critterandguitari/MelodyMillPCB/README.md

# MelodyMillPCB
PCB for Melody Mill Eurorack Module

License is CC BY-SA 2.0
