critterandguitari/MelodyMillPCB/ConectorBoard/pp_module_jack_rev_b_6_up/pp_module_jack_rev_b_6_up_FAB_DRAWING.png

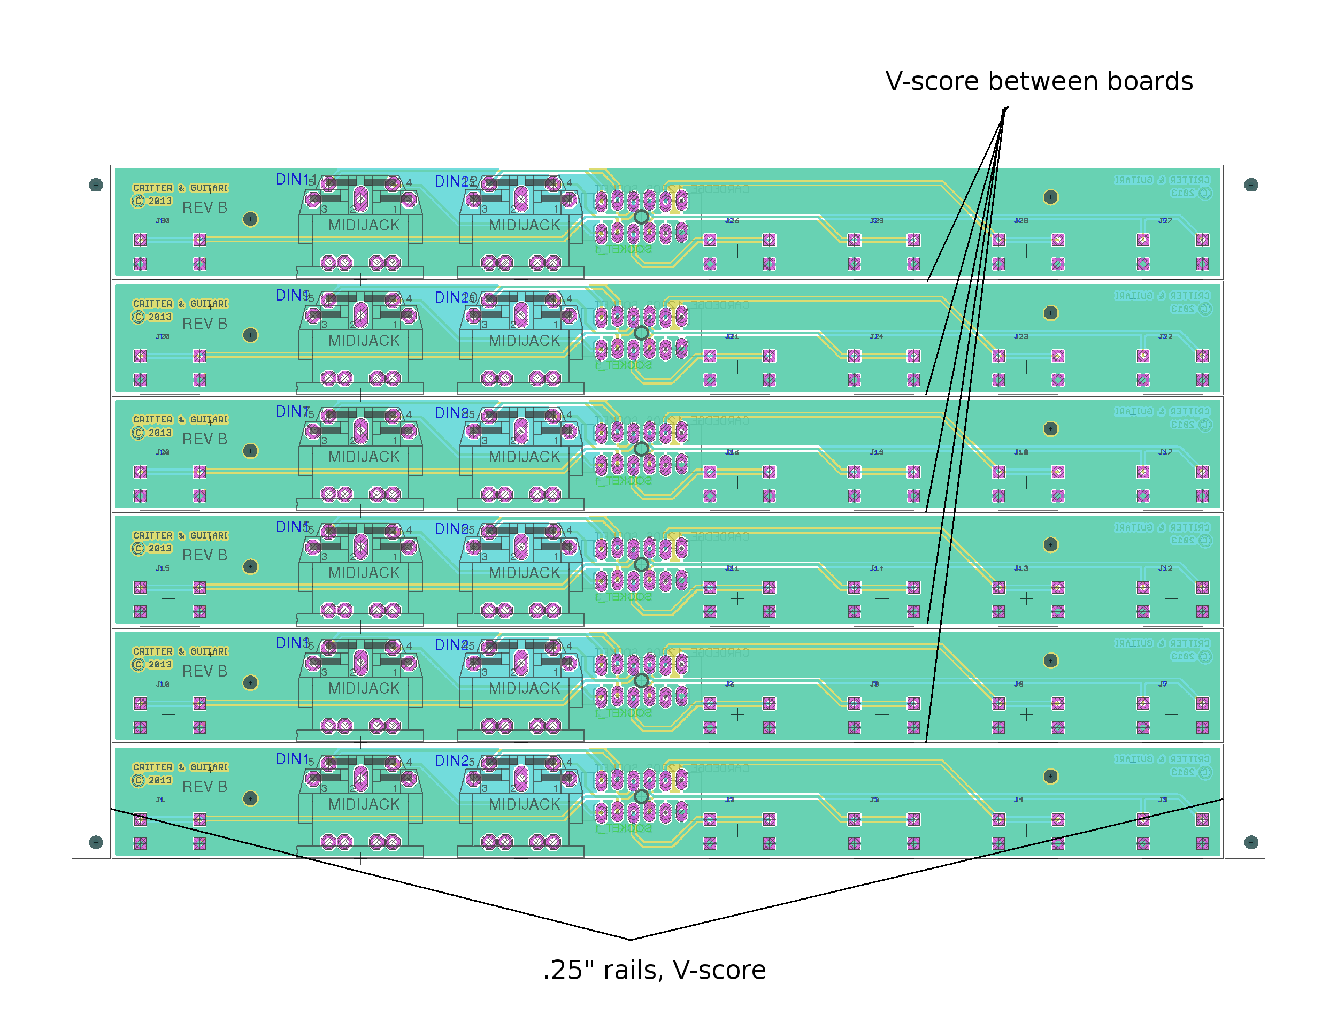
ConectorBoard/pp_module_jack_rev_b_6_up/pp_module_jack_rev_b_6_up_FAB_DRAWING.png
