critterandguitari/MelodyMillPCB/pp_module_rev_c_3_up/pp_module_rev_c_3_up_FAB_DRAWING.png

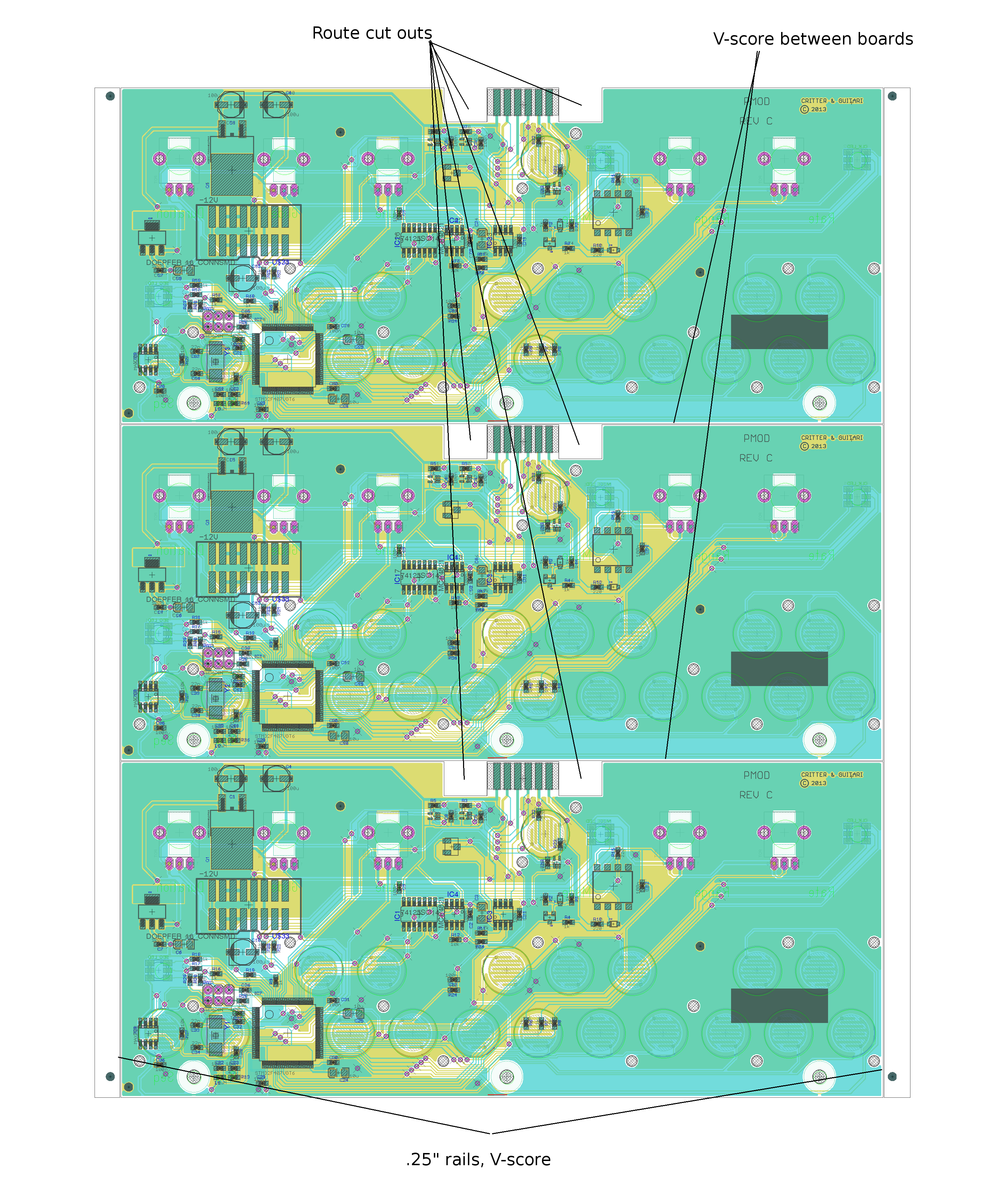
pp_module_rev_c_3_up/pp_module_rev_c_3_up_FAB_DRAWING.png
