critterandguitari/MelodyMillPCB/ConectorBoard/pp_module_jack_rev_b.brd

## EAGLE design ConectorBoard/pp_module_jack_rev_b.brd (2016-05-31)

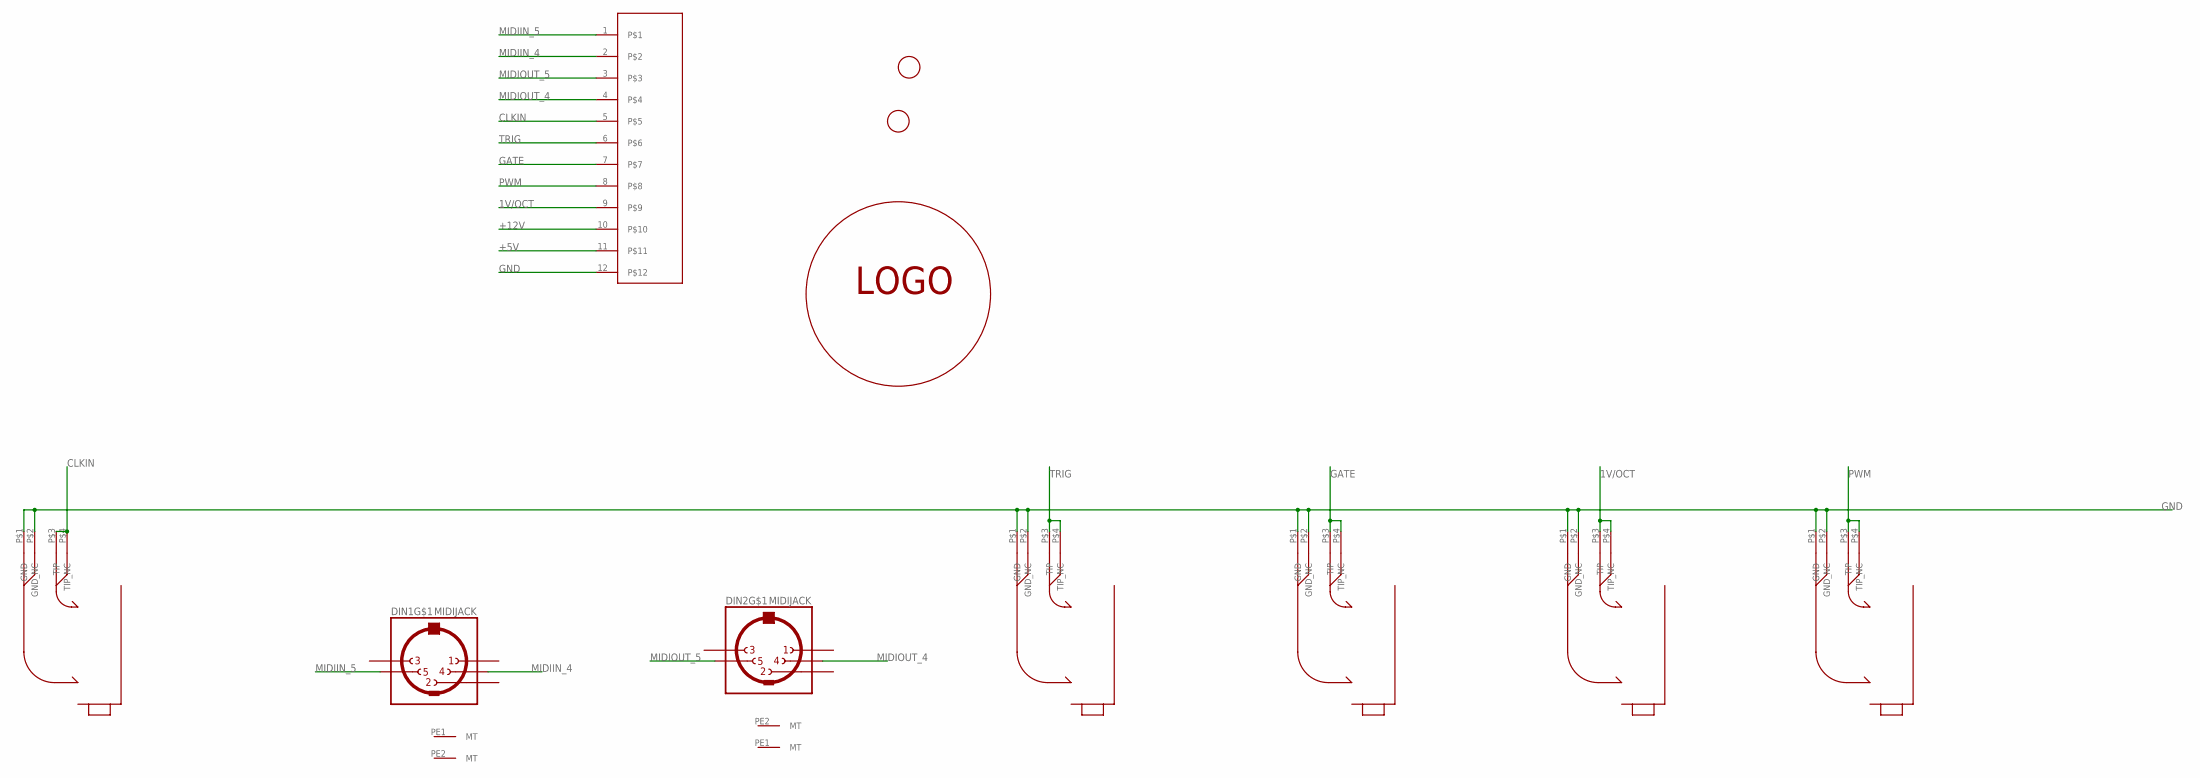
[picture p3: schematic pp_module_jack_rev_b.sch]

Parts:
DIN1, DIN2: MIDIJACK; CP-2350
J1, J2, J3, J4, J5: MONO_JACKCLIFF; CLIFF_JACK
SOCKET_1: CARDEDGE_12POS_SOCKET
U$1, U$2: FIDUCIAL; FIDUCIAL_1MM
U$10: LOGOCG; LOGO-CG

Connections:
1V/OCT: J4.P$3 (TIP), J4.P$4 (TIP_NC), SOCKET_1.9
+5V: SOCKET_1.11
+12V: SOCKET_1.10
CLKIN: J1.P$3 (TIP), J1.P$4 (TIP_NC), SOCKET_1.5
GATE: J3.P$3 (TIP), J3.P$4 (TIP_NC), SOCKET_1.7
GND: J1.P$1 (GND), J1.P$2 (GND_NC), J2.P$1 (GND), J2.P$2 (GND_NC), J3.P$1 (GND), J3.P$2 (GND_NC), J4.P$1 (GND), J4.P$2 (GND_NC), J5.P$1 (GND), J5.P$2 (GND_NC), SOCKET_1.12
MIDIIN_4: DIN1.4, SOCKET_1.2
MIDIIN_5: DIN1.5, SOCKET_1.1
MIDIOUT_4: DIN2.4, SOCKET_1.4
MIDIOUT_5: DIN2.5, SOCKET_1.3
PWM: J5.P$3 (TIP), J5.P$4 (TIP_NC), SOCKET_1.8
TRIG: J2.P$3 (TIP), J2.P$4 (TIP_NC), SOCKET_1.6

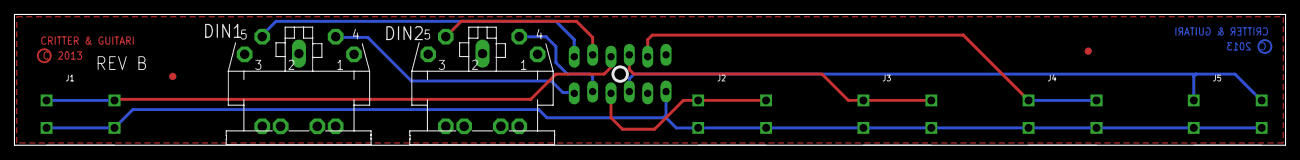
[picture p4: board pp_module_jack_rev_b.brd from above]

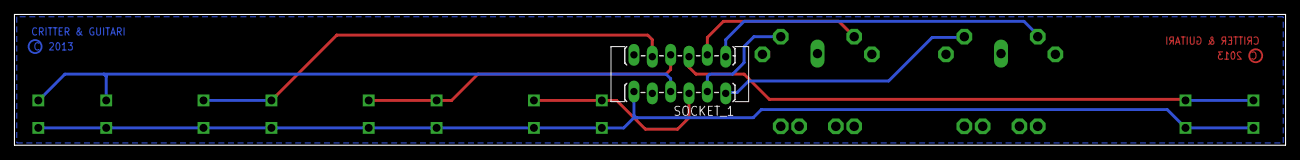
[picture p5: board pp_module_jack_rev_b.brd from below]

Board: 2 copper layers, 175.9 x 18.1 mm, 12 parts (2 on the bottom side), 10 nets.

Other parts of the board:
U$9: LOGOCG; LOGO-CG
