critterandguitari/MelodyMillPCB/pp_module_rev_c.brd

## EAGLE design pp_module_rev_c.brd (2016-05-24)

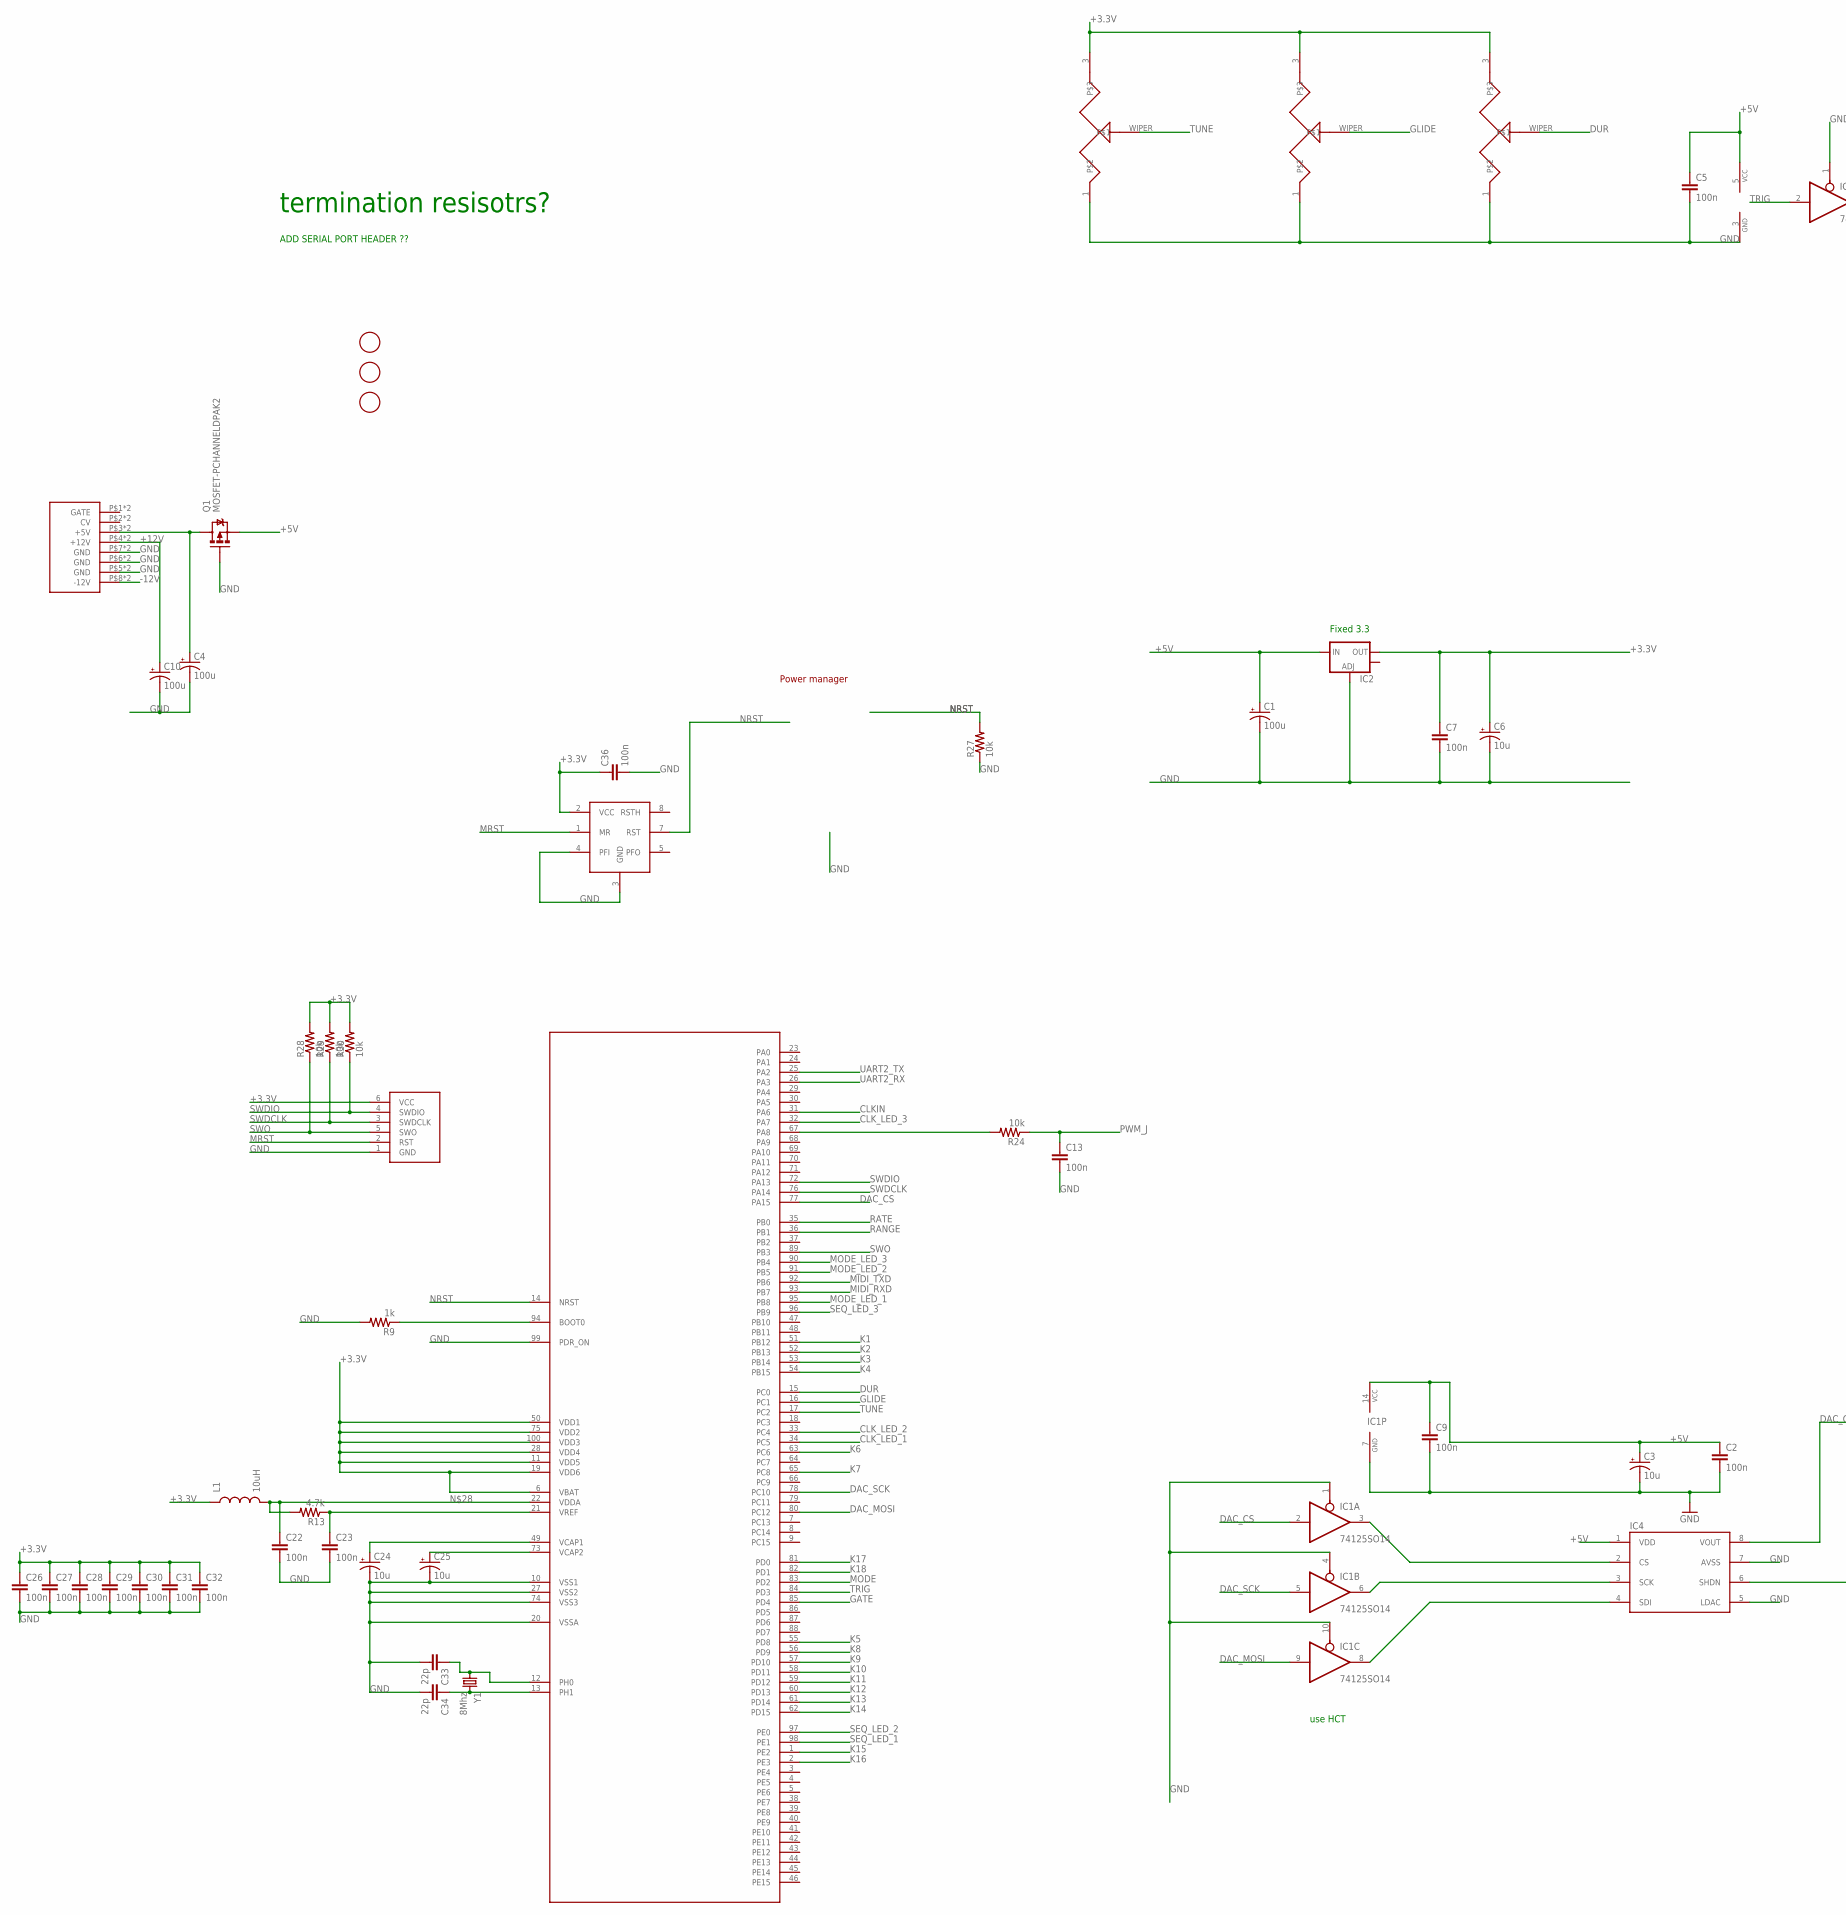
[picture p6: schematic pp_module_rev_c.sch, part in row 1, column 1]

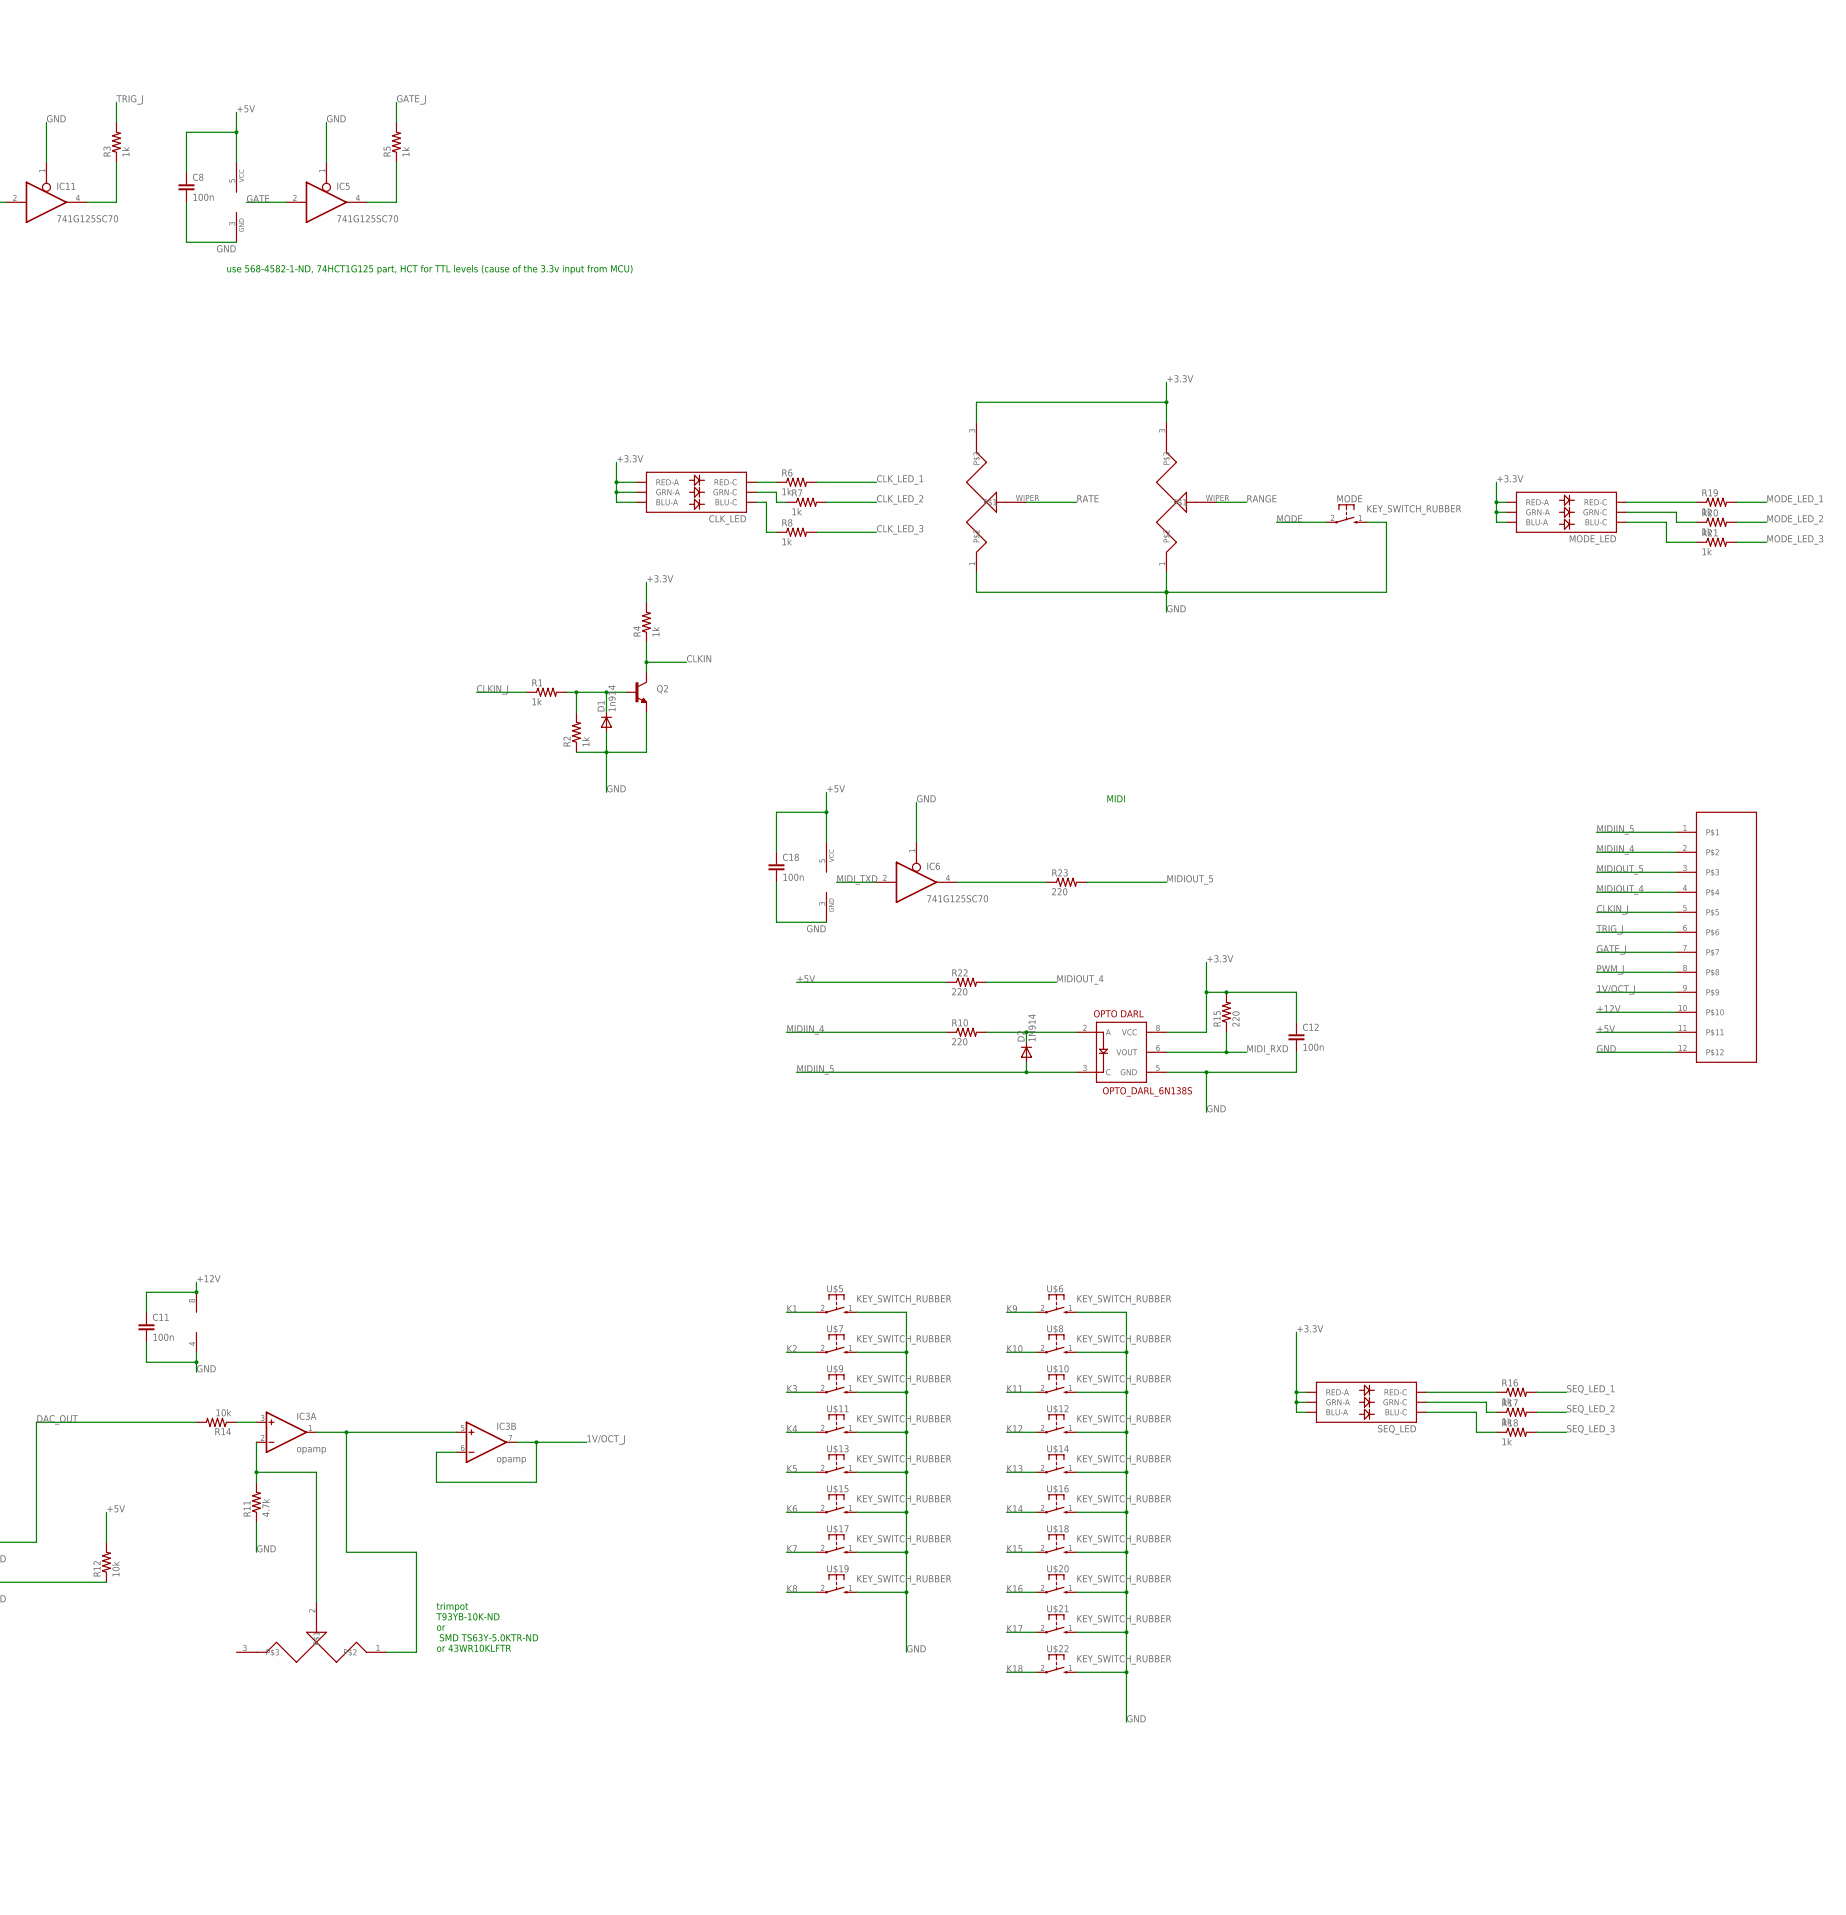
[picture p7: schematic pp_module_rev_c.sch, part in row 1, column 2]

Parts:
C1, C4, C10: 100u; PANASONIC_D
C2, C5, C7, C8, C9, C11, C12, C13, C18, C22, C23, C26, C27, C28, C29, C30, C31, C32, C36: 100n; 0603-CAP
C3, C6, C24, C25: 10u; EIA3216
C33, C34: 22p; 0603-CAP
CLK_LED: LED-TRICOLOR-5050
D1: 1n914; SOD-323
D2: 1N914; SOD-323
DUR: POTVERT; POT-P09X-VERT
GLIDE: POTVERT; POT-P09X-VERT
IC1: 74125SO14; SO14
IC2: V_REG_LM1117SOT223; SOT223
IC3: opamp; SO08
IC4: MCP4821; SO08
IC5, IC6, IC11: 741G125SC70; SC-70
IC7: STM32F407VGT6; LQFP100-14X14
IC9: MAX708; SO08
L1: 10uH; 0603
MODE: KEY_SWITCH_RUBBER; KEY_CONTACT_RUBBER
MODE_LED: LED-TRICOLOR-5050
Q1: MOSFET-PCHANNELDPAK2; DPAK2
Q2: TRANSISTOR_NPNSOT23-3; SOT23-3
R1, R2, R3, R4, R5, R6, R7, R8, R9, R16, R17, R18, R19, R20, R21: 1k; 0603-RES
R10, R15, R22, R23: 220; 0603-RES
R11, R13: 4.7k; 0603-RES
R12, R14, R24, R27, R28, R29, R30: 10k; 0603-RES
RANGE: POTVERT; POT-P09X-VERT
RATE: POTVERT; POT-P09X-VERT
SEQ_LED: LED-TRICOLOR-5050
SWD: SWD6PIN; 2X3
TUNE: POTVERT; POT-P09X-VERT
U$1, U$23, U$24: FIDUCIAL; FIDUCIAL_1MM
U$2: POTSMD-TRIMMER; POT-TRIM-TT-43
U$3: CARDEDGE_12POS_MALE
U$4: OPTO_DARL_6N138S; 8-SMD
U$5, U$6, U$7, U$8, U$9, U$10, U$11, U$12, U$13, U$14, U$15, U$16, U$17, U$18, U$19, U$20, U$21, U$22: KEY_SWITCH_RUBBER; KEY_CONTACT_RUBBER
U$33: DOEPFER_16_CONNSMD; 2X8SMD
Y1: 8Mhz; CRYSTAL-SMD

Connections:
1N914: D1.1 (C), Q2.1 (B), R1.2, R2.2
1V/OCT_J: IC3.6 (-IN), IC3.7 (OUT), U$3.9
+3.3V: C6.A (+), C7.1, C12.1, C26.1, C27.1, C28.1, C29.1, C30.1, C31.1, C32.1, C36.1, CLK_LED.1 (BLU-A), CLK_LED.3 (GRN-A), CLK_LED.5 (RED-A), DUR.3, GLIDE.3, IC2.2 (OUT), IC7.6 (VBAT), IC7.11 (VDD5), IC7.19 (VDD6), IC7.28 (VDD4), IC7.50 (VDD1), IC7.75 (VDD2), IC7.100 (VDD3), IC9.2 (VCC), L1.1, MODE_LED.1 (BLU-A), MODE_LED.3 (GRN-A), MODE_LED.5 (RED-A), R4.2, R15.2, R28.2, R29.2, R30.2, RANGE.3, RATE.3, SEQ_LED.1 (BLU-A), SEQ_LED.3 (GRN-A), SEQ_LED.5 (RED-A), SWD.6 (VCC), TUNE.3, U$4.8 (VCC)
+5V: C1.+, C2.1, C3.A (+), C5.1, C8.1, C9.1, C18.1, IC1.14 (VCC), IC2.3 (IN), IC4.1 (VDD), IC5.5 (VCC), IC6.5 (VCC), IC11.5 (VCC), Q1.3 (S), R12.2, R22.1, U$3.11
+12V: C10.+, C11.1, IC3.8 (V+), U$3.10, U$33.P$4 (+12V), U$33.P$12 (+12V)
-12V: U$33.P$8 (-12V), U$33.P$16 (-12V)
CLKIN: IC7.31 (PA6), Q2.3 (C), R4.1
CLKIN_J: R1.1, U$3.5
CLK_LED_1: IC7.34 (PC5), R6.2
CLK_LED_2: IC7.33 (PC4), R7.2
CLK_LED_3: IC7.32 (PA7), R8.2
DAC_CS: IC1.2 (I), IC7.77 (PA15)
DAC_MOSI: IC1.9 (I), IC7.80 (PC12)
DAC_OUT: IC4.8 (VOUT), R14.2
DAC_SCK: IC1.5 (I), IC7.78 (PC10)
DUR: DUR.WIPER, IC7.15 (PC0)
GATE: IC5.2 (I), IC7.85 (PD4)
GATE_J: R5.2, U$3.7
GLIDE: GLIDE.WIPER, IC7.16 (PC1)
GND: C1.-, C2.2, C3.C (-), C4.-, C5.2, C6.C (-), C7.2, C8.2, C9.2, C10.-, C11.2, C12.2, C13.2, C18.2, C22.2, C23.2, C24.C (-), C25.C (-), C26.2, C27.2, C28.2, C29.2, C30.2, C31.2, C32.2, C33.2, C34.2, C36.2, D1.2 (A), DUR.1, GLIDE.1, IC1.1 (OE), IC1.4 (OE), IC1.7 (GND), IC1.10 (OE), IC2.1 (ADJ), IC3.4 (V-), IC4.5 (LDAC), IC4.7 (AVSS), IC5.1 (OE), IC5.3 (GND), IC6.1 (OE), IC6.3 (GND), IC7.10 (VSS1), IC7.20 (VSSA), IC7.27 (VSS2), IC7.74 (VSS3), IC7.99 (PDR_ON), IC9.3 (GND), IC9.4 (PFI), IC11.1 (OE), IC11.3 (GND), MODE.1 (3), Q1.1 (G), Q2.2 (E), R2.1, R9.2, R11.1, R27.1, RANGE.1, RATE.1, SWD.1 (GND), TUNE.1, U$3.12, U$4.5 (GND), U$5.1 (3), U$6.1 (3), U$7.1 (3), U$8.1 (3), U$9.1 (3), U$10.1 (3), U$11.1 (3), U$12.1 (3), U$13.1 (3), U$14.1 (3), U$15.1 (3), U$16.1 (3), U$17.1 (3), U$18.1 (3), U$19.1 (3), U$20.1 (3), U$21.1 (3), U$22.1 (3), U$33.P$5 (GND), U$33.P$6 (GND), U$33.P$7 (GND), U$33.P$13 (GND), U$33.P$14 (GND), U$33.P$15 (GND)
K1: IC7.51 (PB12), U$5.2 (1)
K2: IC7.52 (PB13), U$7.2 (1)
K3: IC7.53 (PB14), U$9.2 (1)
K4: IC7.54 (PB15), U$11.2 (1)
K5: IC7.55 (PD8), U$13.2 (1)
K6: IC7.63 (PC6), U$15.2 (1)
K7: IC7.65 (PC8), U$17.2 (1)
K8: IC7.56 (PD9), U$19.2 (1)
K9: IC7.57 (PD10), U$6.2 (1)
K10: IC7.58 (PD11), U$8.2 (1)
K11: IC7.59 (PD12), U$10.2 (1)
K12: IC7.60 (PD13), U$12.2 (1)
K13: IC7.61 (PD14), U$14.2 (1)
K14: IC7.62 (PD15), U$16.2 (1)
K15: IC7.1 (PE2), U$18.2 (1)
K16: IC7.2 (PE3), U$20.2 (1)
K17: IC7.81 (PD0), U$21.2 (1)
K18: IC7.82 (PD1), U$22.2 (1)
MIDIIN_4: R10.1, U$3.2
MIDIIN_5: D2.2 (A), U$3.1, U$4.3 (C)
MIDIOUT_4: R22.2, U$3.4
MIDIOUT_5: R23.2, U$3.3
MIDI_RXD: IC7.93 (PB7), R15.1, U$4.6 (VOUT)
MIDI_TXD: IC6.2 (I), IC7.92 (PB6)
MODE: IC7.83 (PD2), MODE.2 (1)
MODE_LED_1: IC7.95 (PB8), R19.2
MODE_LED_2: IC7.91 (PB5), R20.2
MODE_LED_3: IC7.90 (PB4), R21.2
MRST: IC9.1 (MR), SWD.2 (RST)
unnamed: MODE_LED.6 (RED-C), R19.1
unnamed: MODE_LED.4 (GRN-C), R20.1
unnamed: C34.1, IC7.13 (PH1), Y1.2
unnamed: MODE_LED.2 (BLU-C), R21.1
unnamed: C24.A (+), IC7.49 (VCAP1)
unnamed: C33.1, IC7.12 (PH0), Y1.1
unnamed: IC3.2 (-IN), R11.2, U$2.2
unnamed: IC3.3 (+IN), R14.1
unnamed: C4.+, Q1.4 (D), U$33.P$3 (+5V), U$33.P$11 (+5V)
unnamed: IC11.4 (O), R3.1
unnamed: CLK_LED.6 (RED-C), R6.1
unnamed: IC5.4 (O), R5.1
unnamed: IC7.67 (PA8), R24.2
unnamed: CLK_LED.4 (GRN-C), R7.1
unnamed: CLK_LED.2 (BLU-C), R8.1
unnamed: C25.A (+), IC7.73 (VCAP2)
unnamed: IC4.6 (SHDN), R12.1
unnamed: R18.1, SEQ_LED.2 (BLU-C)
unnamed: R17.1, SEQ_LED.4 (GRN-C)
unnamed: IC7.94 (BOOT0), R9.1
unnamed: R16.1, SEQ_LED.6 (RED-C)
unnamed: IC3.1 (OUT), IC3.5 (+IN), U$2.1
unnamed: IC1.3 (O), IC4.2 (CS)
unnamed: C22.1, IC7.22 (VDDA), L1.2, R13.2
unnamed: C23.1, IC7.21 (VREF), R13.1
unnamed: D2.1 (C), R10.2, U$4.2 (A)
unnamed: IC6.4 (O), R23.1
unnamed: IC1.6 (O), IC4.3 (SCK)
unnamed: IC1.8 (O), IC4.4 (SDI)
NRST: IC7.14 (NRST), IC9.7 (RST), R27.2
PWM_J: C13.1, R24.1, U$3.8
RANGE: IC7.36 (PB1), RANGE.WIPER
RATE: IC7.35 (PB0), RATE.WIPER
SEQ_LED_1: IC7.98 (PE1), R16.2
SEQ_LED_2: IC7.97 (PE0), R17.2
SEQ_LED_3: IC7.96 (PB9), R18.2
SWDCLK: IC7.76 (PA14), R29.1, SWD.3 (SWDCLK)
SWDIO: IC7.72 (PA13), R30.1, SWD.4 (SWDIO)
SWO: IC7.89 (PB3), R28.1, SWD.5 (SWO)
TRIG: IC7.84 (PD3), IC11.2 (I)
TRIG_J: R3.2, U$3.6
TUNE: IC7.17 (PC2), TUNE.WIPER
UART2_RX: IC7.26 (PA3)
UART2_TX: IC7.25 (PA2)

Notes on the sheet:
termination resisotrs?
Power manager
ADD SERIAL PORT HEADER ??
Fixed 3.3
use 568-4582-1-ND, 74HCT1G125 part, HCT for TTL levels (cause of the 3.3v input from MCU)
trimpot T93YB-10K-ND or SMD TS63Y-5.0KTR-ND or 43WR10KLFTR
use HCT
MIDI

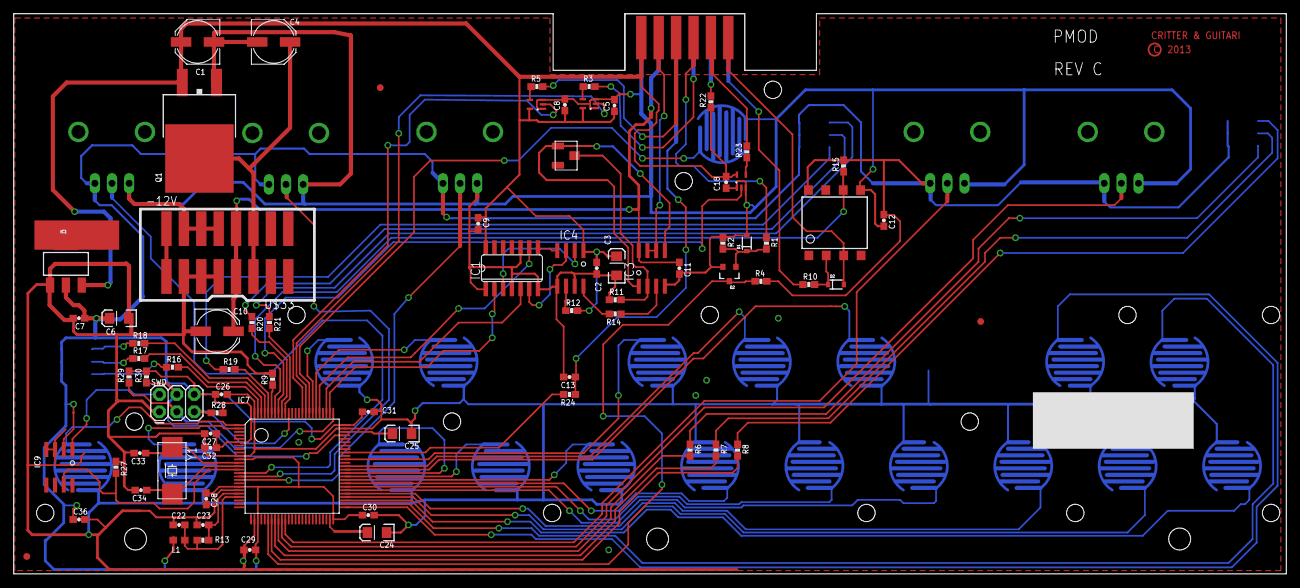
[picture p8: board pp_module_rev_c.brd from above]

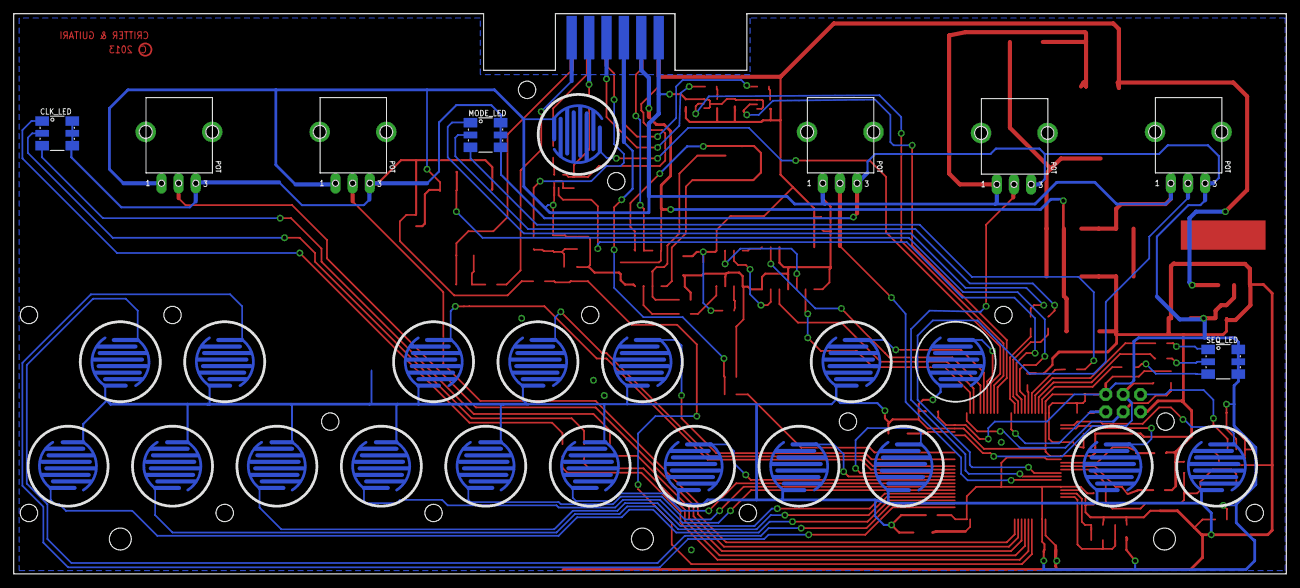
[picture p9: board pp_module_rev_c.brd from below]

Board: 2 copper layers, 185.7 x 81.8 mm, 107 parts (27 on the bottom side), 91 nets.

Other parts of the board:
U$25: LOGOCG; LOGO-CG
