critterandguitari/MelodyMillPCB/ConectorBoard/pp_module_jack_rev_b_6_up.brd

## EAGLE design ConectorBoard/pp_module_jack_rev_b_6_up.brd (2016-05-31)

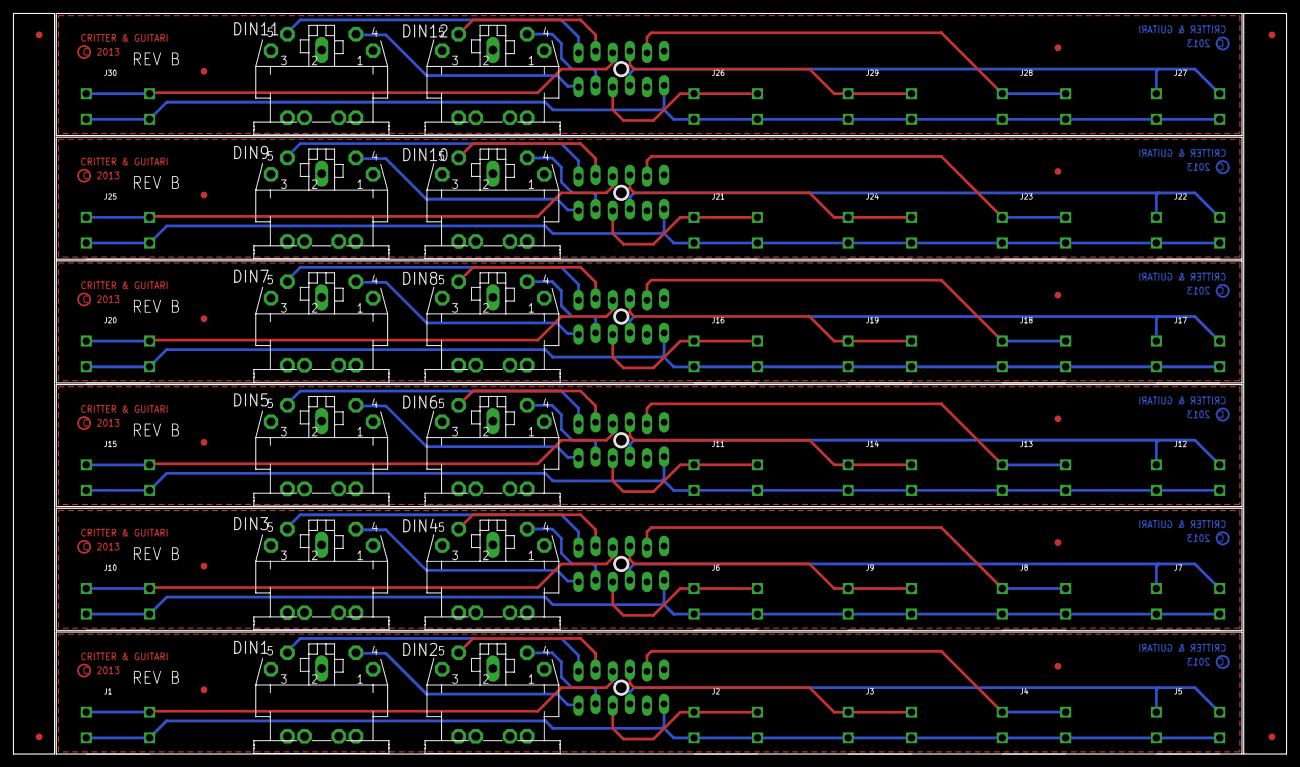
[picture p10: board pp_module_jack_rev_b_6_up.brd from above]

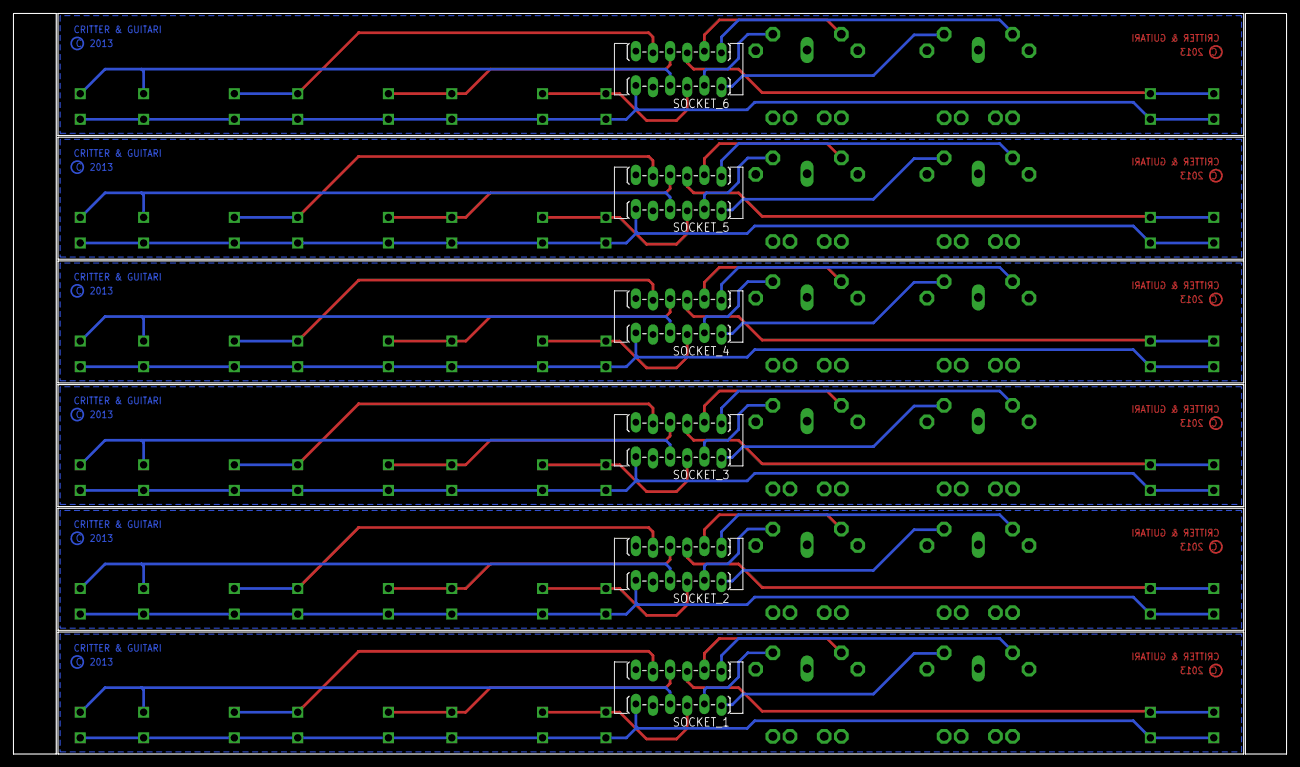
[picture p11: board pp_module_jack_rev_b_6_up.brd from below]

Board: 2 copper layers, 188.8 x 109.9 mm, 76 parts (12 on the bottom side), 60 nets.

Parts:
DIN1, DIN2, DIN3, DIN4, DIN5, DIN6, DIN7, DIN8, DIN9, DIN10, DIN11, DIN12: MIDIJACK; CP-2350
E$1, E$2, E$3, E$4: FIDUCIAL_1MM
J1, J2, J3, J4, J5, J6, J7, J8, J9, J10, J11, J12, J13, J14, J15, J16, J17, J18, J19, J20, J21, J22, J23, J24, J25, J26, J27, J28, J29, J30: MONO_JACKCLIFF; CLIFF_JACK
SOCKET_1, SOCKET_2, SOCKET_3, SOCKET_4, SOCKET_5, SOCKET_6: CARDEDGE_12POS_SOCKET
U$1, U$2, U$5, U$6, U$11, U$12, U$15, U$16, U$19, U$20, U$23, U$24: FIDUCIAL; FIDUCIAL_1MM
U$3, U$4, U$7, U$8, U$9, U$10, U$13, U$14, U$17, U$18, U$21, U$22: LOGOCG; LOGO-CG

Connections:
1V/OCT: J4.P$3, J4.P$4, SOCKET_1.9
1V/OCT1: J8.P$3, J8.P$4, SOCKET_2.9
1V/OCT2: J13.P$3, J13.P$4, SOCKET_3.9
1V/OCT3: J18.P$3, J18.P$4, SOCKET_4.9
1V/OCT4: J23.P$3, J23.P$4, SOCKET_5.9
1V/OCT5: J28.P$3, J28.P$4, SOCKET_6.9
CLKIN: J1.P$3, J1.P$4, SOCKET_1.5
CLKIN1: J10.P$3, J10.P$4, SOCKET_2.5
CLKIN2: J15.P$3, J15.P$4, SOCKET_3.5
CLKIN3: J20.P$3, J20.P$4, SOCKET_4.5
CLKIN4: J25.P$3, J25.P$4, SOCKET_5.5
CLKIN5: J30.P$3, J30.P$4, SOCKET_6.5
GATE: J3.P$3, J3.P$4, SOCKET_1.7
GATE1: J9.P$3, J9.P$4, SOCKET_2.7
GATE2: J14.P$3, J14.P$4, SOCKET_3.7
GATE3: J19.P$3, J19.P$4, SOCKET_4.7
GATE4: J24.P$3, J24.P$4, SOCKET_5.7
GATE5: J29.P$3, J29.P$4, SOCKET_6.7
GND: J1.P$1, J1.P$2, J2.P$1, J2.P$2, J3.P$1, J3.P$2, J4.P$1, J4.P$2, J5.P$1, J5.P$2, SOCKET_1.12
GND1: J6.P$1, J6.P$2, J7.P$1, J7.P$2, J8.P$1, J8.P$2, J9.P$1, J9.P$2, J10.P$1, J10.P$2, SOCKET_2.12
GND2: J11.P$1, J11.P$2, J12.P$1, J12.P$2, J13.P$1, J13.P$2, J14.P$1, J14.P$2, J15.P$1, J15.P$2, SOCKET_3.12
GND3: J16.P$1, J16.P$2, J17.P$1, J17.P$2, J18.P$1, J18.P$2, J19.P$1, J19.P$2, J20.P$1, J20.P$2, SOCKET_4.12
GND4: J21.P$1, J21.P$2, J22.P$1, J22.P$2, J23.P$1, J23.P$2, J24.P$1, J24.P$2, J25.P$1, J25.P$2, SOCKET_5.12
GND5: J26.P$1, J26.P$2, J27.P$1, J27.P$2, J28.P$1, J28.P$2, J29.P$1, J29.P$2, J30.P$1, J30.P$2, SOCKET_6.12
MIDIIN_1: DIN3.4, SOCKET_2.2
MIDIIN_2: DIN3.5, SOCKET_2.1
MIDIIN_3: DIN5.4, SOCKET_3.2
MIDIIN_4: DIN1.4, SOCKET_1.2
MIDIIN_5: DIN1.5, SOCKET_1.1
MIDIIN_6: DIN5.5, SOCKET_3.1
MIDIIN_7: DIN7.4, SOCKET_4.2
MIDIIN_8: DIN7.5, SOCKET_4.1
MIDIIN_9: DIN9.4, SOCKET_5.2
MIDIIN_10: DIN9.5, SOCKET_5.1
MIDIIN_11: DIN11.4, SOCKET_6.2
MIDIIN_12: DIN11.5, SOCKET_6.1
MIDIOUT_1: DIN4.5, SOCKET_2.3
MIDIOUT_2: DIN4.4, SOCKET_2.4
MIDIOUT_3: DIN6.5, SOCKET_3.3
MIDIOUT_4: DIN2.4, SOCKET_1.4
MIDIOUT_5: DIN2.5, SOCKET_1.3
MIDIOUT_6: DIN6.4, SOCKET_3.4
MIDIOUT_7: DIN8.5, SOCKET_4.3
MIDIOUT_8: DIN8.4, SOCKET_4.4
MIDIOUT_9: DIN10.5, SOCKET_5.3
MIDIOUT_10: DIN10.4, SOCKET_5.4
MIDIOUT_11: DIN12.5, SOCKET_6.3
MIDIOUT_12: DIN12.4, SOCKET_6.4
PWM: J5.P$3, J5.P$4, SOCKET_1.8
PWM1: J7.P$3, J7.P$4, SOCKET_2.8
PWM2: J12.P$3, J12.P$4, SOCKET_3.8
PWM3: J17.P$3, J17.P$4, SOCKET_4.8
PWM4: J22.P$3, J22.P$4, SOCKET_5.8
PWM5: J27.P$3, J27.P$4, SOCKET_6.8
TRIG: J2.P$3, J2.P$4, SOCKET_1.6
TRIG1: J6.P$3, J6.P$4, SOCKET_2.6
TRIG2: J11.P$3, J11.P$4, SOCKET_3.6
TRIG3: J16.P$3, J16.P$4, SOCKET_4.6
TRIG4: J21.P$3, J21.P$4, SOCKET_5.6
TRIG5: J26.P$3, J26.P$4, SOCKET_6.6
