critterandguitari/MelodyMillPCB/pp_module_rev_c_3_up.brd

## EAGLE design pp_module_rev_c_3_up.brd (2016-05-24)

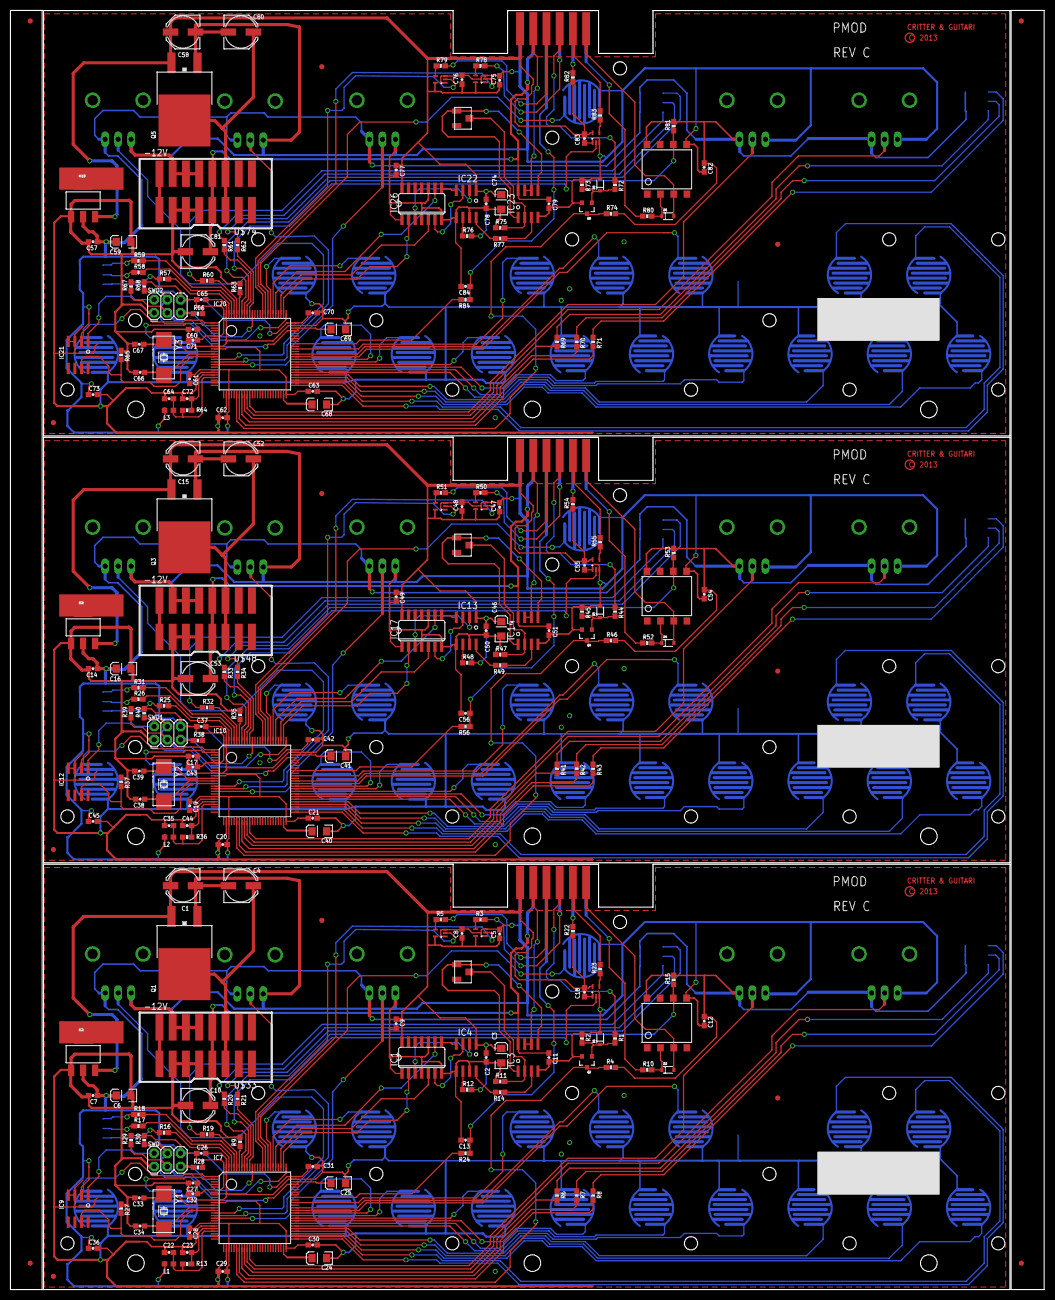
[picture p12: board pp_module_rev_c_3_up.brd from above]

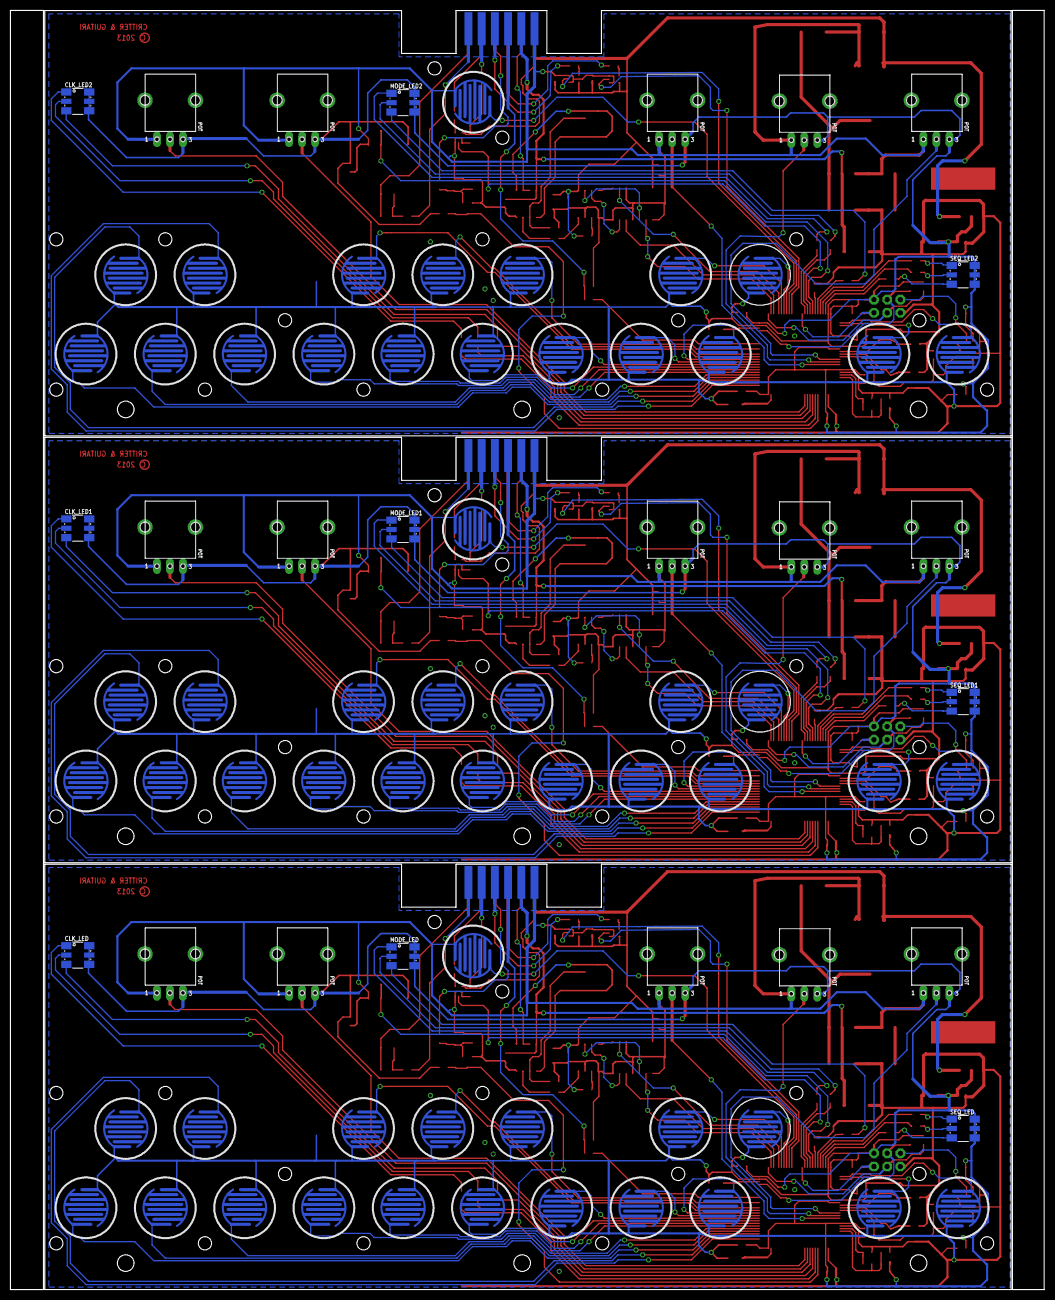
[picture p13: board pp_module_rev_c_3_up.brd from below]

Board: 2 copper layers, 198.7 x 245.9 mm, 325 parts (81 on the bottom side), 273 nets.

Parts:
C1, C4, C10, C15, C52, C53, C58, C80, C81: 100u; PANASONIC_D
C2, C5, C7, C8, C9, C11, C12, C13, C14, C17, C18, C19, C20, C21, C22, C23, C26, C27, C28, C29, C30, C31, C32, C35, C36, C37, C42, C43, C44, C45, C47, C48, C49, C50, C51, C54, C55, C56, C57, C60, C61, C62, C63, C64, C65, C70, C71, C72, C73, C75, C76, C77, C78, C79, C82, C83, C84: 100n; 0603-CAP
C3, C6, C16, C24, C25, C40, C41, C46, C59, C68, C69, C74: 10u; EIA3216
C33, C34, C38, C39, C66, C67: 22p; 0603-CAP
CLK_LED, CLK_LED1, CLK_LED2: LED-TRICOLOR-5050
D1, D2, D3, D4, D5, D6: SOD-323
DUR, DUR1, DUR2: POTVERT; POT-P09X-VERT
E$1, E$2, E$3, E$4: FIDUCIAL_1MM
GLIDE, GLIDE1, GLIDE2: POTVERT; POT-P09X-VERT
IC1, IC17, IC26: 74125SO14; SO14
IC2, IC8, IC19: SOT223
IC3, IC14, IC23: SO08
IC4, IC13, IC22: MCP4821; SO08
IC5, IC6, IC11, IC15, IC16, IC18, IC24, IC25, IC27: 741G125SC70; SC-70
IC7, IC10, IC20: STM32F407VGT6; LQFP100-14X14
IC9, IC12, IC21: MAX708; SO08
L1, L2, L3: 10uH; 0603
MODE, MODE1, MODE2: KEY_SWITCH_RUBBER; KEY_CONTACT_RUBBER
MODE_LED, MODE_LED1, MODE_LED2: LED-TRICOLOR-5050
Q1, Q3, Q5: MOSFET-PCHANNELDPAK2; DPAK2
Q2, Q4, Q6: SOT23-3
R1, R2, R3, R4, R5, R6, R7, R8, R9, R16, R17, R18, R19, R20, R21, R25, R26, R31, R32, R33, R34, R35, R41, R42, R43, R44, R45, R46, R50, R51, R57, R58, R59, R60, R61, R62, R63, R69, R70, R71, R72, R73, R74, R78, R79: 1k; 0603-RES
R10, R15, R22, R23, R52, R53, R54, R55, R80, R81, R82, R83: 220; 0603-RES
R11, R13, R36, R47, R64, R75: 4.7k; 0603-RES
R12, R14, R24, R27, R28, R29, R30, R37, R38, R39, R40, R48, R49, R56, R65, R66, R67, R68, R76, R77, R84: 10k; 0603-RES
RANGE, RANGE1, RANGE2: POTVERT; POT-P09X-VERT
RATE, RATE1, RATE2: POTVERT; POT-P09X-VERT
SEQ_LED, SEQ_LED1, SEQ_LED2: LED-TRICOLOR-5050
SWD, SWD1, SWD2: SWD6PIN; 2X3
TUNE, TUNE1, TUNE2: POTVERT; POT-P09X-VERT
U$1, U$23, U$24, U$45, U$47, U$52, U$71, U$73, U$78: FIDUCIAL; FIDUCIAL_1MM
U$2, U$49, U$75: POTSMD-TRIMMER; POT-TRIM-TT-43
U$3, U$50, U$76: CARDEDGE_12POS_MALE
U$4, U$51, U$77: OPTO_DARL_6N138S; 8-SMD
U$5, U$6, U$7, U$8, U$9, U$10, U$11, U$12, U$13, U$14, U$15, U$16, U$17, U$18, U$19, U$20, U$21, U$22, U$26, U$27, U$28, U$29, U$30, U$31, U$32, U$34, U$35, U$36, U$37, U$38, U$39, U$40, U$41, U$42, U$43, U$44, U$53, U$54, U$55, U$56, U$57, U$58, U$59, U$60, U$61, U$62, U$63, U$64, U$65, U$66, U$67, U$68, U$69, U$70: KEY_SWITCH_RUBBER; KEY_CONTACT_RUBBER
U$25, U$46, U$72: LOGOCG; LOGO-CG
U$33, U$48, U$74: DOEPFER_16_CONNSMD; 2X8SMD
Y1, Y2, Y3: CRYSTAL-SMD

Connections:
1V/OCT_J: IC3.6, IC3.7, U$3.9
1V/OCT_J1: IC14.6, IC14.7, U$50.9
1V/OCT_J2: IC23.6, IC23.7, U$76.9
+3.3V: C6.A, C7.1, C12.1, C26.1, C27.1, C28.1, C29.1, C30.1, C31.1, C32.1, C36.1, CLK_LED.1, CLK_LED.3, CLK_LED.5, DUR.3, GLIDE.3, IC2.2, IC7.6, IC7.11, IC7.19, IC7.28, IC7.50, IC7.75, IC7.100, IC9.2, L1.1, MODE_LED.1, MODE_LED.3, MODE_LED.5, R4.2, R15.2, R28.2, R29.2, R30.2, RANGE.3, RATE.3, SEQ_LED.1, SEQ_LED.3, SEQ_LED.5, SWD.6, TUNE.3, U$4.8
+3.3V1: C14.1, C16.A, C17.1, C19.1, C20.1, C21.1, C37.1, C42.1, C43.1, C45.1, C54.1, CLK_LED1.1, CLK_LED1.3, CLK_LED1.5, DUR1.3, GLIDE1.3, IC8.2, IC10.6, IC10.11, IC10.19, IC10.28, IC10.50, IC10.75, IC10.100, IC12.2, L2.1, MODE_LED1.1, MODE_LED1.3, MODE_LED1.5, R38.2, R39.2, R40.2, R46.2, R53.2, RANGE1.3, RATE1.3, SEQ_LED1.1, SEQ_LED1.3, SEQ_LED1.5, SWD1.6, TUNE1.3, U$51.8
+3.3V2: C57.1, C59.A, C60.1, C61.1, C62.1, C63.1, C65.1, C70.1, C71.1, C73.1, C82.1, CLK_LED2.1, CLK_LED2.3, CLK_LED2.5, DUR2.3, GLIDE2.3, IC19.2, IC20.6, IC20.11, IC20.19, IC20.28, IC20.50, IC20.75, IC20.100, IC21.2, L3.1, MODE_LED2.1, MODE_LED2.3, MODE_LED2.5, R66.2, R67.2, R68.2, R74.2, R81.2, RANGE2.3, RATE2.3, SEQ_LED2.1, SEQ_LED2.3, SEQ_LED2.5, SWD2.6, TUNE2.3, U$77.8
+5V: C1.+, C2.1, C3.A, C5.1, C8.1, C9.1, C18.1, IC1.14, IC2.3, IC4.1, IC5.5, IC6.5, IC11.5, Q1.3, R12.2, R22.1, U$3.11
+5V1: C15.+, C46.A, C47.1, C48.1, C49.1, C50.1, C55.1, IC8.3, IC13.1, IC15.5, IC16.5, IC17.14, IC18.5, Q3.3, R48.2, R54.1, U$50.11
+5V2: C58.+, C74.A, C75.1, C76.1, C77.1, C78.1, C83.1, IC19.3, IC22.1, IC24.5, IC25.5, IC26.14, IC27.5, Q5.3, R76.2, R82.1, U$76.11
+12V: C10.+, C11.1, IC3.8, U$3.10, U$33.P$4, U$33.P$12
+12V1: C51.1, C53.+, IC14.8, U$48.P$4, U$48.P$12, U$50.10
+12V2: C79.1, C81.+, IC23.8, U$74.P$4, U$74.P$12, U$76.10
-12V: U$33.P$8, U$33.P$16
-12V1: U$48.P$8, U$48.P$16
-12V2: U$74.P$8, U$74.P$16
CLKIN: IC7.31, Q2.3, R4.1
CLKIN1: IC10.31, Q4.3, R46.1
CLKIN2: IC20.31, Q6.3, R74.1
CLKIN_J: R1.1, U$3.5
CLKIN_J1: R44.1, U$50.5
CLKIN_J2: R72.1, U$76.5
CLK_LED_1: IC7.34, R6.2
CLK_LED_2: IC7.33, R7.2
CLK_LED_3: IC7.32, R8.2
CLK_LED_4: IC10.34, R41.2
CLK_LED_5: IC10.33, R42.2
CLK_LED_6: IC10.32, R43.2
CLK_LED_7: IC20.34, R69.2
CLK_LED_8: IC20.33, R70.2
CLK_LED_9: IC20.32, R71.2
DAC_CS: IC1.2, IC7.77
DAC_CS1: IC10.77, IC17.2
DAC_CS2: IC20.77, IC26.2
DAC_MOSI: IC1.9, IC7.80
DAC_MOSI1: IC10.80, IC17.9
DAC_MOSI2: IC20.80, IC26.9
DAC_OUT: IC4.8, R14.2
DAC_OUT1: IC13.8, R49.2
DAC_OUT2: IC22.8, R77.2
DAC_SCK: IC1.5, IC7.78
DAC_SCK1: IC10.78, IC17.5
DAC_SCK2: IC20.78, IC26.5
DUR: DUR.WIPER, IC7.15
DUR1: DUR1.WIPER, IC10.15
DUR2: DUR2.WIPER, IC20.15
GATE: IC5.2, IC7.85
GATE1: IC10.85, IC16.2
GATE2: IC20.85, IC25.2
GATE_J: R5.2, U$3.7
GATE_J1: R51.2, U$50.7
GATE_J2: R79.2, U$76.7
GLIDE: GLIDE.WIPER, IC7.16
GLIDE1: GLIDE1.WIPER, IC10.16
GLIDE2: GLIDE2.WIPER, IC20.16
GND: C1.-, C2.2, C3.C, C4.-, C5.2, C6.C, C7.2, C8.2, C9.2, C10.-, C11.2, C12.2, C13.2, C18.2, C22.2, C23.2, C24.C, C25.C, C26.2, C27.2, C28.2, C29.2, C30.2, C31.2, C32.2, C33.2, C34.2, C36.2, D1.2, DUR.1, GLIDE.1, IC1.1, IC1.4, IC1.7, IC1.10, IC2.1, IC3.4, IC4.5, IC4.7, IC5.1, IC5.3, IC6.1, IC6.3, IC7.10, IC7.20, IC7.27, IC7.74, IC7.99, IC9.3, IC9.4, IC11.1, IC11.3, MODE.1, Q1.1, Q2.2, R2.1, R9.2, R11.1, R27.1, RANGE.1, RATE.1, SWD.1, TUNE.1, U$3.12, U$4.5, U$5.1, U$6.1, U$7.1, U$8.1, U$9.1, U$10.1, U$11.1, U$12.1, U$13.1, U$14.1, U$15.1, U$16.1, U$17.1, U$18.1, U$19.1, U$20.1, U$21.1, U$22.1, U$33.P$5, U$33.P$6, U$33.P$7, U$33.P$13, U$33.P$14, U$33.P$15
GND1: C14.2, C15.-, C16.C, C17.2, C19.2, C20.2, C21.2, C35.2, C37.2, C38.2, C39.2, C40.C, C41.C, C42.2, C43.2, C44.2, C45.2, C46.C, C47.2, C48.2, C49.2, C50.2, C51.2, C52.-, C53.-, C54.2, C55.2, C56.2, D3.2, DUR1.1, GLIDE1.1, IC8.1, IC10.10, IC10.20, IC10.27, IC10.74, IC10.99, IC12.3, IC12.4, IC13.5, IC13.7, IC14.4, IC15.1, IC15.3, IC16.1, IC16.3, IC17.1, IC17.4, IC17.7, IC17.10, IC18.1, IC18.3, MODE1.1, Q3.1, Q4.2, R35.2, R37.1, R45.1, R47.1, RANGE1.1, RATE1.1, SWD1.1, TUNE1.1, U$26.1, U$27.1, U$28.1, U$29.1, U$30.1, U$31.1, U$32.1, U$34.1, U$35.1, U$36.1, U$37.1, U$38.1, U$39.1, U$40.1, U$41.1, U$42.1, U$43.1, U$44.1, U$48.P$5, U$48.P$6, U$48.P$7, U$48.P$13, U$48.P$14, U$48.P$15, U$50.12, U$51.5
GND2: C57.2, C58.-, C59.C, C60.2, C61.2, C62.2, C63.2, C64.2, C65.2, C66.2, C67.2, C68.C, C69.C, C70.2, C71.2, C72.2, C73.2, C74.C, C75.2, C76.2, C77.2, C78.2, C79.2, C80.-, C81.-, C82.2, C83.2, C84.2, D5.2, DUR2.1, GLIDE2.1, IC19.1, IC20.10, IC20.20, IC20.27, IC20.74, IC20.99, IC21.3, IC21.4, IC22.5, IC22.7, IC23.4, IC24.1, IC24.3, IC25.1, IC25.3, IC26.1, IC26.4, IC26.7, IC26.10, IC27.1, IC27.3, MODE2.1, Q5.1, Q6.2, R63.2, R65.1, R73.1, R75.1, RANGE2.1, RATE2.1, SWD2.1, TUNE2.1, U$53.1, U$54.1, U$55.1, U$56.1, U$57.1, U$58.1, U$59.1, U$60.1, U$61.1, U$62.1, U$63.1, U$64.1, U$65.1, U$66.1, U$67.1, U$68.1, U$69.1, U$70.1, U$74.P$5, U$74.P$6, U$74.P$7, U$74.P$13, U$74.P$14, U$74.P$15, U$76.12, U$77.5
K1: IC7.51, U$5.2
K2: IC7.52, U$7.2
K3: IC7.53, U$9.2
K4: IC7.54, U$11.2
K5: IC7.55, U$13.2
K6: IC7.63, U$15.2
K7: IC7.65, U$17.2
K8: IC7.56, U$19.2
K9: IC7.57, U$6.2
K10: IC7.58, U$8.2
K11: IC7.59, U$10.2
K12: IC7.60, U$12.2
K13: IC7.61, U$14.2
K14: IC7.62, U$16.2
K15: IC7.1, U$18.2
K16: IC7.2, U$20.2
K17: IC7.81, U$21.2
K18: IC7.82, U$22.2
K19: IC10.51, U$26.2
K20: IC10.52, U$27.2
K21: IC10.53, U$28.2
K22: IC10.54, U$29.2
K23: IC10.55, U$30.2
K24: IC10.63, U$31.2
K25: IC10.65, U$32.2
K26: IC10.56, U$34.2
K27: IC10.2, U$42.2
K28: IC10.1, U$41.2
K29: IC10.62, U$40.2
K30: IC10.61, U$39.2
K31: IC10.60, U$38.2
K32: IC10.59, U$37.2
K33: IC10.58, U$36.2
K34: IC10.57, U$35.2
K35: IC10.81, U$43.2
K36: IC10.82, U$44.2
K37: IC20.51, U$53.2
K38: IC20.52, U$54.2
K39: IC20.53, U$55.2
K40: IC20.54, U$56.2
K41: IC20.55, U$57.2
K42: IC20.63, U$58.2
K43: IC20.65, U$59.2
K44: IC20.56, U$60.2
K45: IC20.2, U$68.2
K46: IC20.1, U$67.2
K47: IC20.62, U$66.2
K48: IC20.61, U$65.2
K49: IC20.60, U$64.2
K50: IC20.59, U$63.2
K51: IC20.58, U$62.2
K52: IC20.57, U$61.2
K53: IC20.81, U$69.2
K54: IC20.82, U$70.2
MIDIIN_1: D4.2, U$50.1, U$51.3
MIDIIN_2: R52.1, U$50.2
MIDIIN_3: D6.2, U$76.1, U$77.3
MIDIIN_4: R10.1, U$3.2
MIDIIN_5: D2.2, U$3.1, U$4.3
MIDIIN_6: R80.1, U$76.2
MIDIOUT_1: R55.2, U$50.3
MIDIOUT_2: R54.2, U$50.4
MIDIOUT_3: R83.2, U$76.3
MIDIOUT_4: R22.2, U$3.4
MIDIOUT_5: R23.2, U$3.3
MIDIOUT_6: R82.2, U$76.4
MIDI_RXD: IC7.93, R15.1, U$4.6
MIDI_RXD1: IC10.93, R53.1, U$51.6
MIDI_RXD2: IC20.93, R81.1, U$77.6
MIDI_TXD: IC6.2, IC7.92
MIDI_TXD1: IC10.92, IC18.2
MIDI_TXD2: IC20.92, IC27.2
MODE: IC7.83, MODE.2
MODE1: IC10.83, MODE1.2
MODE2: IC20.83, MODE2.2
MODE_LED_1: IC7.95, R19.2
MODE_LED_2: IC7.91, R20.2
MODE_LED_3: IC7.90, R21.2
MODE_LED_4: IC10.95, R32.2
MODE_LED_5: IC10.91, R33.2
MODE_LED_6: IC10.90, R34.2
MODE_LED_7: IC20.95, R60.2
MODE_LED_8: IC20.91, R61.2
MODE_LED_9: IC20.90, R62.2
MRST: IC9.1, SWD.2
MRST1: IC12.1, SWD1.2
MRST2: IC21.1, SWD2.2
unnamed: MODE_LED.6, R19.1
unnamed: MODE_LED.4, R20.1
unnamed: C34.1, IC7.13, Y1.2
unnamed: MODE_LED.2, R21.1
unnamed: C24.A, IC7.49
unnamed: C33.1, IC7.12, Y1.1
unnamed: IC3.2, R11.2, U$2.2
unnamed: IC3.3, R14.1
unnamed: C4.+, Q1.4, U$33.P$3, U$33.P$11
unnamed: IC11.4, R3.1
unnamed: CLK_LED.6, R6.1
unnamed: IC5.4, R5.1
unnamed: IC7.67, R24.2
unnamed: CLK_LED.4, R7.1
unnamed: CLK_LED.2, R8.1
unnamed: R31.1, SEQ_LED1.2
unnamed: C25.A, IC7.73
unnamed: IC4.6, R12.1
unnamed: R18.1, SEQ_LED.2
unnamed: R17.1, SEQ_LED.4
unnamed: IC7.94, R9.1
unnamed: R16.1, SEQ_LED.6
unnamed: R26.1, SEQ_LED1.4
unnamed: IC3.1, IC3.5, U$2.1
unnamed: R25.1, SEQ_LED1.6
unnamed: MODE_LED1.6, R32.1
unnamed: IC1.3, IC4.2
unnamed: C22.1, IC7.22, L1.2, R13.2
unnamed: C23.1, IC7.21, R13.1
unnamed: D2.1, R10.2, U$4.2
unnamed: MODE_LED1.4, R33.1
unnamed: MODE_LED1.2, R34.1
unnamed: C38.1, IC10.13, Y2.2
unnamed: IC6.4, R23.1
unnamed: C39.1, IC10.12, Y2.1
unnamed: IC1.6, IC4.3
unnamed: IC1.8, IC4.4
unnamed: D1.1, Q2.1, R1.2, R2.2
unnamed: IC10.94, R35.1
unnamed: C41.A, IC10.73
unnamed: C40.A, IC10.49
unnamed: C35.1, IC10.22, L2.2, R36.2
unnamed: C44.1, IC10.21, R36.1
unnamed: IC13.6, R48.1
unnamed: IC14.2, R47.2, U$49.2
unnamed: IC14.3, R49.1
unnamed: C52.+, Q3.4, U$48.P$3, U$48.P$11
unnamed: IC15.4, R50.1
unnamed: IC16.4, R51.1
unnamed: CLK_LED1.6, R41.1
unnamed: CLK_LED1.4, R42.1
unnamed: CLK_LED1.2, R43.1
unnamed: IC14.1, IC14.5, U$49.1
unnamed: IC13.2, IC17.3
unnamed: IC13.3, IC17.6
unnamed: IC13.4, IC17.8
unnamed: D3.1, Q4.1, R44.2, R45.2
unnamed: D4.1, R52.2, U$51.2
unnamed: IC18.4, R55.1
unnamed: IC10.67, R56.2
unnamed: R59.1, SEQ_LED2.2
unnamed: R58.1, SEQ_LED2.4
unnamed: R57.1, SEQ_LED2.6
unnamed: MODE_LED2.6, R60.1
unnamed: MODE_LED2.4, R61.1
unnamed: MODE_LED2.2, R62.1
unnamed: C66.1, IC20.13, Y3.2
unnamed: C67.1, IC20.12, Y3.1
unnamed: IC20.94, R63.1
unnamed: C69.A, IC20.73
unnamed: C68.A, IC20.49
unnamed: C64.1, IC20.22, L3.2, R64.2
unnamed: C72.1, IC20.21, R64.1
unnamed: IC22.6, R76.1
unnamed: IC23.2, R75.2, U$75.2
unnamed: IC23.3, R77.1
unnamed: C80.+, Q5.4, U$74.P$3, U$74.P$11
unnamed: IC24.4, R78.1
unnamed: IC25.4, R79.1
unnamed: CLK_LED2.6, R69.1
unnamed: CLK_LED2.4, R70.1
unnamed: CLK_LED2.2, R71.1
unnamed: IC23.1, IC23.5, U$75.1
unnamed: IC22.2, IC26.3
unnamed: IC22.3, IC26.6
unnamed: IC22.4, IC26.8
unnamed: D5.1, Q6.1, R72.2, R73.2
unnamed: D6.1, R80.2, U$77.2
unnamed: IC27.4, R83.1
unnamed: IC20.67, R84.2
NRST: IC7.14, IC9.7, R27.2
NRST1: IC10.14, IC12.7, R37.2
NRST2: IC20.14, IC21.7, R65.2
PWM_J: C13.1, R24.1, U$3.8
PWM_J1: C56.1, R56.1, U$50.8
PWM_J2: C84.1, R84.1, U$76.8
RANGE: IC7.36, RANGE.WIPER
RANGE1: IC10.36, RANGE1.WIPER
RANGE2: IC20.36, RANGE2.WIPER
RATE: IC7.35, RATE.WIPER
RATE1: IC10.35, RATE1.WIPER
RATE2: IC20.35, RATE2.WIPER
SEQ_LED_1: IC7.98, R16.2
SEQ_LED_2: IC7.97, R17.2
SEQ_LED_3: IC7.96, R18.2
SEQ_LED_4: IC10.98, R25.2
SEQ_LED_5: IC10.97, R26.2
SEQ_LED_6: IC10.96, R31.2
SEQ_LED_7: IC20.98, R57.2
SEQ_LED_8: IC20.97, R58.2
SEQ_LED_9: IC20.96, R59.2
SWDCLK: IC7.76, R29.1, SWD.3
SWDCLK1: IC10.76, R39.1, SWD1.3
SWDCLK2: IC20.76, R67.1, SWD2.3
SWDIO: IC7.72, R30.1, SWD.4
SWDIO1: IC10.72, R40.1, SWD1.4
SWDIO2: IC20.72, R68.1, SWD2.4
SWO: IC7.89, R28.1, SWD.5
SWO1: IC10.89, R38.1, SWD1.5
SWO2: IC20.89, R66.1, SWD2.5
TRIG: IC7.84, IC11.2
TRIG1: IC10.84, IC15.2
TRIG2: IC20.84, IC24.2
TRIG_J: R3.2, U$3.6
TRIG_J1: R50.2, U$50.6
TRIG_J2: R78.2, U$76.6
TUNE: IC7.17, TUNE.WIPER
TUNE1: IC10.17, TUNE1.WIPER
TUNE2: IC20.17, TUNE2.WIPER
